schmelczer/ad_astra/promo_source/hf/IMG_20200516_105644.jpg

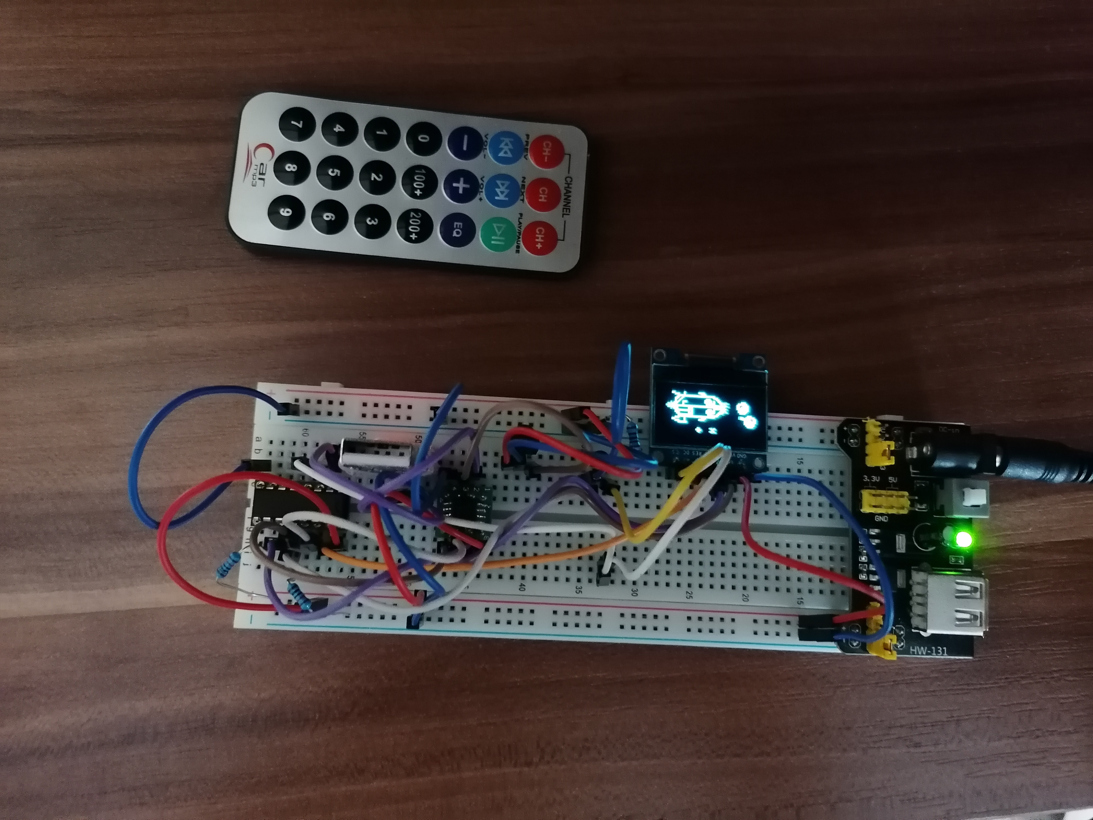
promo_source/hf/IMG_20200516_105644.jpg
