schmelczer/ad_astra/README.md

# Ad astra

## Demonstration

[View it on YouTube](https://youtu.be/BRTg24UXhKg)

## Directories
- [sprite_generator](sprite_generator/)
    > Contains a python script for transforming [Piskel](https://www.piskelapp.com/) sprites 
    > into C files.
- [ad_astra](ad_astra/)
    > Contains the source files for the game
