schmelczer/ad_astra/docs/documentation.pdf

Név: Schmelczer András | Neptun kód: CVTNXD

Beadás dátuma: 2020. 05. 19.

Házi feladat címe: Szimulációs játék

## Mikrokontrollerek alkalmazástechnikája házi feladat

### ATtiny85-ös mikrokontrollerrel szeretnék megvalósítani egy infrás távirányítóval irányítható játékot. A játék futásához nem kell emberi beavatkozás, magától is történnek benne események, viszont, ha fogunk egy távirányítót, akkor az egyik

karaktert (a három közül) irányíthatjuk vele. A videójáték űrhajós tematikájú, amiben fejlődni az aszteroidák szétlövésével lehetséges.

### A feladatot önállóan, meg nem engedett segítség nélkül oldottam meg:

### aláírás

Szimulációs játék | Schmelczer András

# Részletes specifikáció

A játék futásához nem kell emberi beavatkozás, magától is történnek benne események, viszont, amennyiben fogunk egy távirányítót, akkor az egyik karaktert irányíthatjuk vele. A rendszer 3.3 V-ról működtethető, fogyasztása nem haladja meg a 15 mW-ot.

Infrán keresztüli NEC protokollal történő kommunikációval hét különböző kérést küldhetünk. A kijelző fényereje állítható növekvő és csökkenő irányban, a képernyőn látható egyik karakter mozgatható négy irányban, illetve a képernyőn látható karakter késztethető cselekvésre.

A rendszerrel továbbá UART-on keresztül is lehet kommunikálni. Küldeni a távirányító által küldhető parancsok karakteres megfelelőjét lehet. Ezek az előző sorrenddel megegyezően a következők: ’+’, ’-’, ’w’, ’a’, ’s’, ’d’, ’ ’. Visszafele pedig egy képkocka kirajzolásának ideje érkezik pár másodperces időközönként.

Maga a játék az űrben játszódik. Ezen belül egy űrhajóban található a játékos által irányított karakter és pár másik, a gép által irányított karakter is. A karakterek az űrhajót irányíthatják (ehhez az irányítópulthoz kell menni, és megnyomni az akciógombot). Az űrhajóval lőni is lehet, ehhez egy másik irányítópulthoz kell menni. Az űrhajó egy részének a képernyőn mindig látszania kell, így azt nem lehet bármilyen távolra elirányítani.

Vizuálisan oldalnézetű képeket látunk. Az űrhajó kétszintes, ezek között, illetve ezeken belül tudnak a karakterek közlekedni. A két szintet egy létra köti össze, amelyen fel és lefele is lehet közlekedni. A lefele mozgásnak a létrán kívül nincs következménye. A felfele mozgást a létrán kívül végrehajtva egy ugró animációt láthatunk.

Ütközésnek számít az és csak az, amikor az űrhajó legalább egy sötét pixele fedésben van az aszteroida egy sötét pixelével. Az űrhajó ütközhet az aszteroidákkal, ilyenkor az energiája csökken. Az energia lövés hatására is csökken. Erről visszajelzést egy az űrhajó spritejába integrált csík szolgáltat. Ha a csík hosszúsága nulla, a játéknak vége, és egy effekt lejátszása után elölről kezdődik. Ezt elkerülendő a fedélzet megfelelő pontján kell az akciógombot megnyomni, ilyenkor újra feltöltődik a csík. Néha megjelennek aszteroidák, melyek szétlőhetők.

A spriteok animálhatók és az átlátszóság is biztosított. A háttérben csillagok mozognak véletlenszerű konfigurációkban. Utóbbiaknak nincs hatása a játékmenetre. Követelmény továbbá, hogy legalább 50 képkockát kirajzoljon másodpercenként legalább 64 x 32 pixeles felbontásban.

A játéknak figyelembe kell vennie az eddig felrobbantott aszteroidák számát, és ennek függvényében újabb funkciókat kell a játékos számára biztosítani. Ezek a funkciók sorrendben a következők: energia növelés lehetősége, lövés lehetősége, első segítő végül pedig a második segítő.

A segítők másik karaktereket jelölnek, akik egy többszintes szabályrendszert követve próbálják a játék előrehaladását segíteni. Minden funkció elérhető számukra, ami a játékos rendelkezésére is áll.

# Funkcionális blokkvázlat

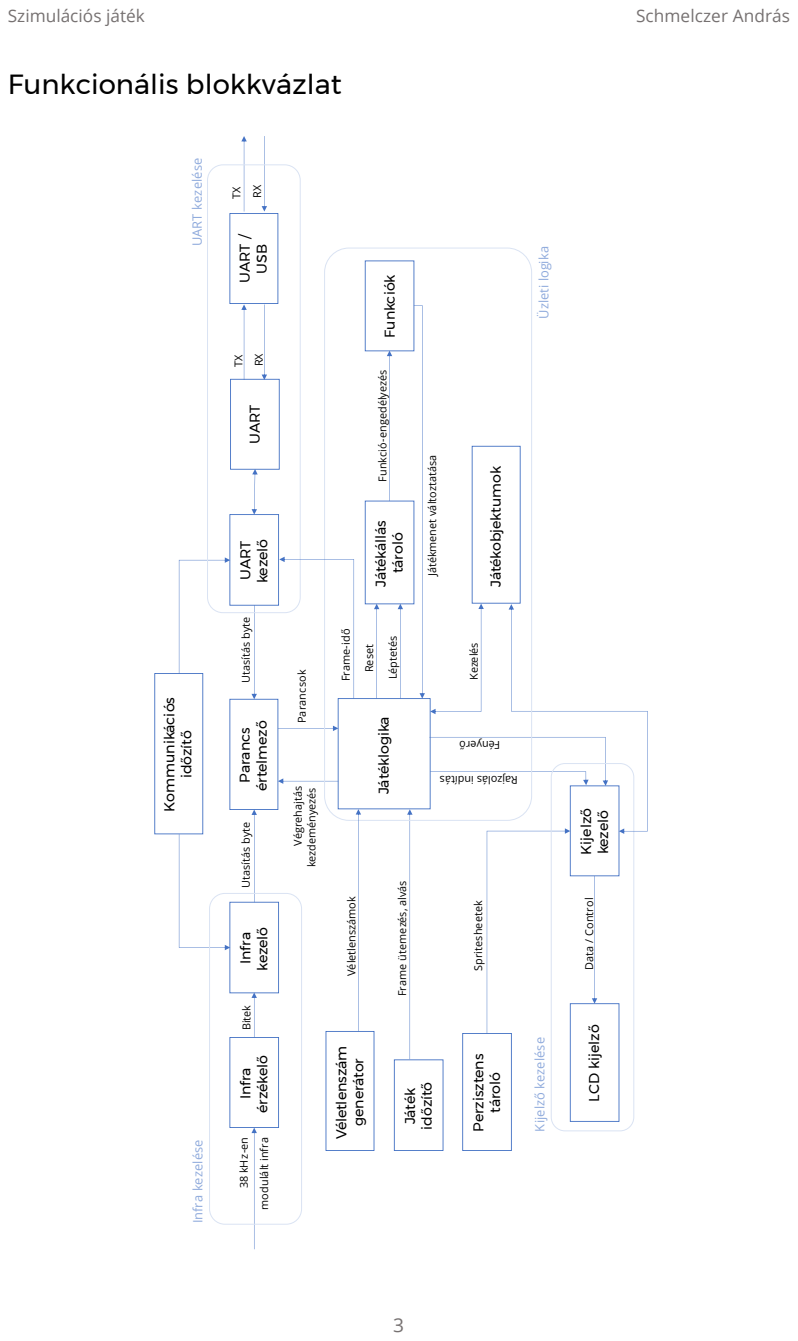
[picture p3: page 3]
Végrehajtás; kezdeményezés; arancsok; Véletlenszámok; pritesheetek; ata Control; itek k z -en; modulált infra; ijelző kezelése; eset; ezelés; zleti logika; átékmenet változtatása; rame-idő

nfra kezelése A kezelése

éptetés unkció-engedélyezés

tasítás byte

rame ütemezés, alvás

## Részletesebben

A specifikáció alapján az előző oldalon található blokkvázlatot készítettem. Sokat gondolkoztam a megfelelő absztrakciós szinten. Végül amellett döntöttem, hogy a játéklogika fáradtságos részletezése helyett annak csak a specifikációban kiemelt fő részeit tüntetem fel. Az eszköz viselkedésére már ennyiből is kellően nagy pontossággal lehet következtetni, a pontos implementáció és felbontás pedig rendkívül sokféle lehet. Szerencsére a többi követelmény elég egyértelműen vetíthető funkcionális blokkokra.

Mivel parancsokat több forrásból is kaphat a rendszer így a komplexitás csökkentése végett, azokhoz közös feldolgozóegységet célszerű használni. A kommunikációs protokollok bonyolultsága miatt ezekhez kezelőket is célszerű alkalmazni, így a rendszer többi része könnyebben veheti igénybe őket. Ezeknek a kezelőknek időzítőre is szükségük lesz.

Többször említésre került a követelmények közt a véletlenszerűségre igénye, ezek megvalósításához szükséges egy véletlenszám-generátor is. Továbbá explicit nem szerepelt a perzisztens tároló szükségessége, viszont az animált sprite-ok tárolását ezzel megoldhatjuk.

Az üzleti logika felel a követelményrendszer nagyobb részének teljesítéséért. Ennek kiemelendő funkciói a játékállapotának és a játék objektumoknak a felügyelete. Emellett a többi komponens működésének összeegyeztetése is ezen egység feladata.

# Hardver szoftver szétválasztás

Ezek után a hardver szoftver szétválasztás többnyire egyértelmű lesz. A ki és bemenetek (infra, UART, LCD) természetesen hardveresen kerülnek megvalósításra. Az időzítők és tárhely pedig a mikrokontrollerek felépítéséből következően szintén hardveresen manifesztálódnak. Jó hír, hogy ezeken kívül minden funkció megvalósítható szoftveresen is. A felbontást vizuálisan a következő oldalon láthatjuk.

## Diagram

A hardver által megvalósított részeket kék háttérszínű téglalapokkal jelöltem.

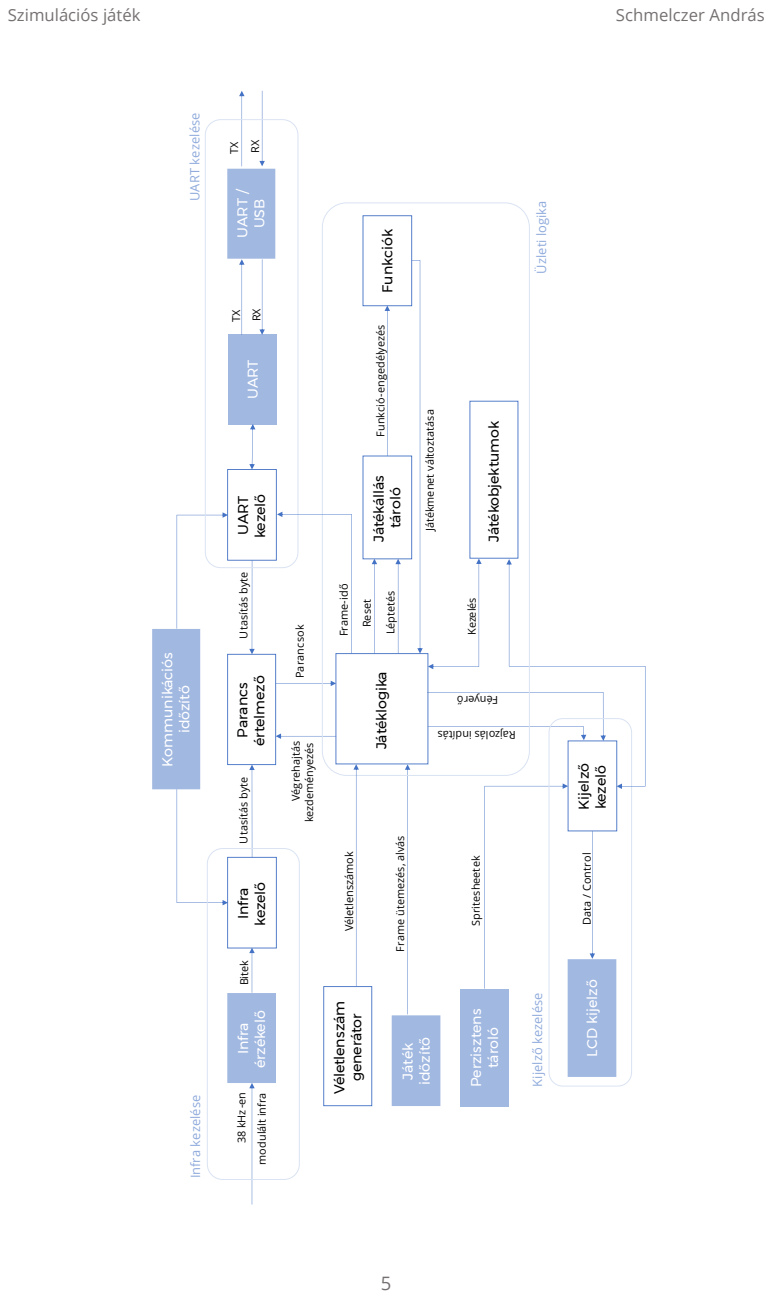
[picture p4: page 5]
Végrehajtás; kezdeményezés; arancsok; Véletlenszámok; pritesheetek; ata Control; itek k z -en; modulált infra; ijelző kezelése; eset; ezelés; zleti logika; átékmenet változtatása; rame-idő

nfra kezelése A kezelése

éptetés unkció-engedélyezés

tasítás byte

rame ütemezés, alvás

## Hardver blokkvázlat

Maga a mikrokontroller a korábban említett ATtiny85-ös lesz. Ez egy kellően olcsó és kis-
méretű eszköz, meglepően magas teljesítménnyel. | átránya a kisméretű | AM és
programmemória. Ezeket ügyes programozással kell áthidalni.

Egy 128 x 64 pixel felbontású SPI-on kommunikáló kijelző szolgál kimenetként, egy TSOP szériás infra érzékelő pedig bemenetként. A kijelző felbontása (és beépített hardveres gyorsítása) lehetővé teszi a kétszeres upscaling használatát, így elég 64 x 2 pixelnyi képet kiszámolni. Fejlesztés alatt a mikrokontroller debugWIRE interface-én kerül sor a debugolásra. A tárgykövetelmények miatt UART-os kommunikációra is szükség lesz, viszont a lábak elfogytak, így a kimeneti lábakat egy shift-regiszterrel kell bővíteni, amivel kvázi -on keresztül lehet kommunikálni.

A (kimeneti) portbővítés az eddigi funkcionális leírásokban nem szerepelt, hiszen ez nem a specifikációban részletezett funkcionalitáshoz szükséges, hanem egyszerűen a mikrokontroller kis lábszáma által okozott akadályt szünteti meg.

A két SPI lábakat használó periféria miatt szükséges a chip-select jelek használata, ezt egy inverter alkalmazásával biztosítom.

A mikrokontroller beépített USI-ja az | kezelésre lesz konfigurálva, lévén ez az időkriti-
kusabb a relatíve nagy sávszélességet igénylő képkockák átküldése miatt. Az A | és az
infra kezelésére pedig maradnak a pin change és timer interruptok.

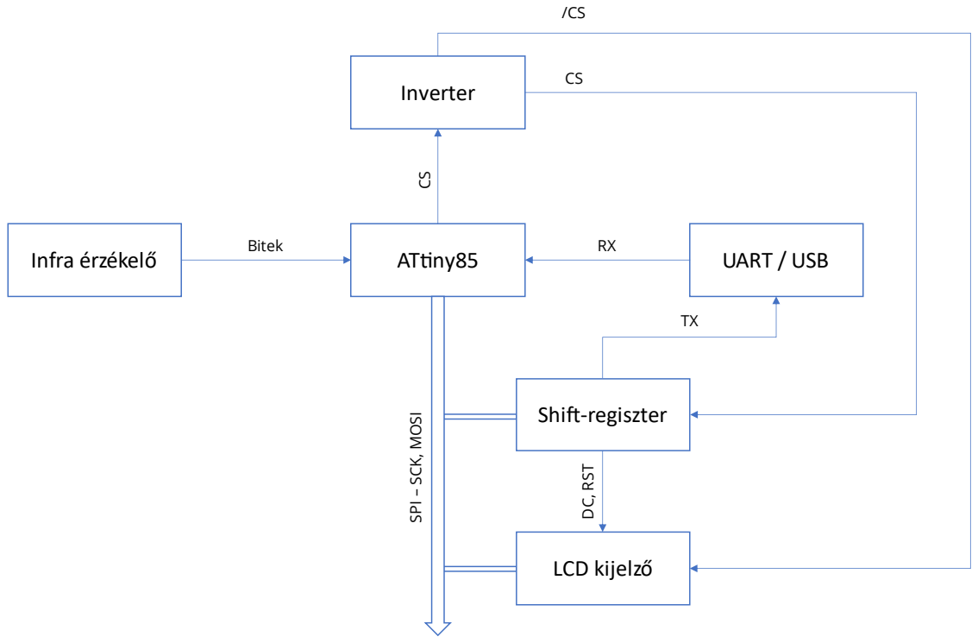
[picture p5: figure]
itek

# Kapcsolási rajz

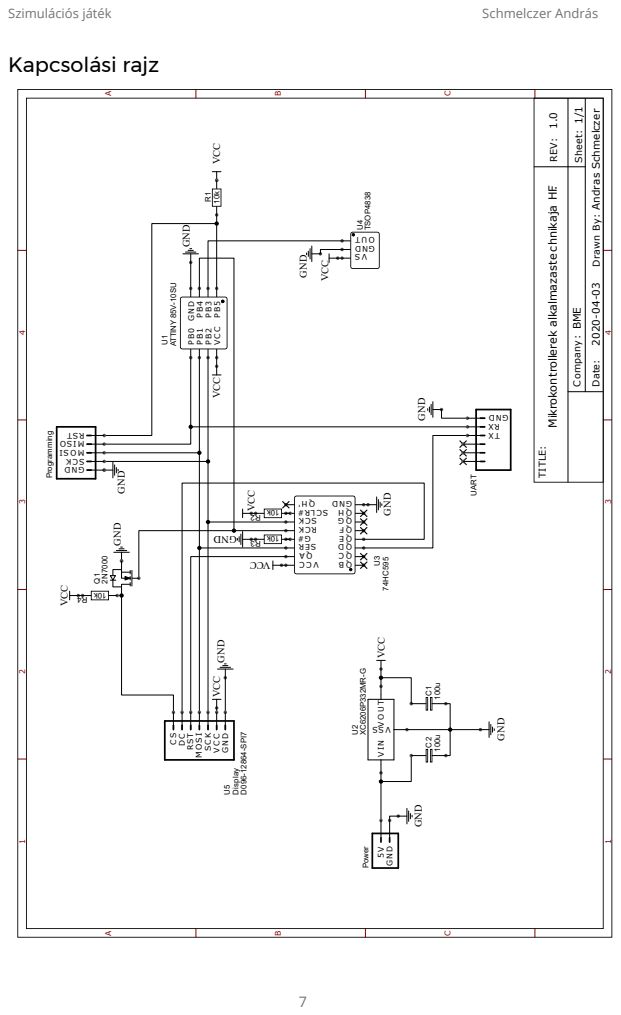
[picture p6: page 7]

# Szoftver rendszerterv

A teljes szoftveres dokumentációt mérete miatt nem illesztettem be ebbe a dokumentációba. A kommentek és a kód felépítése alapján doxygen-nel és pdlatex-kel generált dokumentáció a software_documentation.pdf fájlban található meg nyomtatható verzióban. öngésző segítségével célszerűbb a kereshető software_documentation/index.html fájlon keresztül elérhető dokumentációt használni.

Ebben a részben csak átfogóbb képet szeretnék adni a rendszerről. A részleteket az előbb említett helyen lehet megtalálni.

## Elvek

A szoftver architektúrájának tervezésekor fő szempontok voltak a modularitás, hordozhatóság és a teljesítmény. Nem elhanyagolható igény továbbá a kis méret sem. Mindezek teljesítése végett több alkalommal ismerhető fel az objektum-orientált szemlélet.

Ezek miatt a programban nincs globálisan elérhető állapot, a komponensek saját állapotukat felügyelik, velük függvényhívásokkal lehet kommunikálni.

## Hardverközeli

Madártávlatból három fő részre osztható a kódbázis. egalul helyezkedik el a hardware-access, ami a legalapvetőbb hardveres funkciókat látja el egy kényelmesen használható API-val. A következő hardver funkciókért felelős modulok találhatók itt.

- Energiahatékonyság
- SPI (sebesség végett blokkoló működés)
- dőzítés (megszakítás alapú működés)
- Digitális kimenet

Másik mikrokontrollerre váltás esetén a változtatások túlnyomó része az előbbi elemekben várható.

Ez a réteg rendelkezik egy açade jellegű interfésszel, aminek két felelőssége van. Egyrészt deklarálja a hardware-access által biztosított funkciókat. Másrészt a teljes hardveres inicializálásért felel. tóbbira a kis méret és az egyszerű használat miatt van szükség. A program elején inicializáljuk a HAL-t, utána pedig bárhol includeolva a megfelelő headert, a teljes hardver funkcionalitást elérjük.

## Driverek

A következő réteg a driver réteg. Az itteni modulok lazán csatoltak és egyetlen közös tulajdonságuk, hogy a HAL-t használják funkcionalitásuk megvalósításához.

A következő komponensek helyezkednek el itt.

- ijelző
- Infra (megszakítás alapú működés)
- Alvásütemezés
- UART (megszakítás alapú működés)

Ezek többnyire egy egyszerű interfész (callback függvény) átadásával inicializálhatók. Erre a laza csatoltság miatt van szükség, igazából ez a dependency inversion principle C nyelvi megvalósítása.

A legmagasabb szintű funkciók az alkalmazás réteg-ben találhatók. Maga a játék és annak logikája itt kerül megvalósításra. Ez saját belső architektúrával rendelkezik, amit a későbbiekben fogok kifejteni.

Végül egy fontos komponens maradt még. A mediator az alkalmazás és a driverek között helyezkedik el. iztosítja, hogy az előbbi két rétegen belül és azok közt megvalósulhasson a kommunikáció. elelőssége a komponensek orkesztrációja. Mindezt a megfelelő fejlécű függvények átadásával éri el a megfelelő inicializáló függvényhívásokban.

## Alkalmazáslogika

A fő szempont a magasszintű kód írásának lehetővé tétele és a kompakt méret. Ezért a játékobjektumok közt egy prototípus alapú öröklési rendszer került kialakításra. Minden típus rendelkezik egy prototípussal, ami a méretét, a rajzoló és a frissítő függvényét tartalmazza. Maguk a prototípusok a programmemóriában kerülnek tárolásra. Az objektumok rendelkeznek egy mutatóval a prototípusukra, egy pozícióval és egy unionnel, amiben a típus specifikus állapotukat tárolják.

Az objektumok tárolására az objektumtároló szolgál. Ez igazából egy heterogén kollekció pár hasznos függvénnyel. Például segítségével lekérdezhetők az objektumok típus alapján vagy az alapján, hogy adott pixel pozíciót tartalmazzák-e. Továbbá az objektumok frissítését és rajzolását lehet innen kezdeményezni.

Az időközönkénti új objektumok létrehozását az esemény generátor kezdeményezi. Emellett a játékmenetért (indítás, újraindításért) felelős komponens is ebben a rétegben kerül megvalósításra.

Az összes játékobjektum típus rendelkezik saját komponenssel. Adott feladatukat a program többi részét használva igen magas szintű kóddal lehet megvalósítani. Önálló komponense van továbbá az AI-nak, ami az élő felhasználó által használható interfészen keresztül irányíthatja a karaktereket.

Megemlíthető, hogy a kirajzolásra szánt spritesheetek is itt kerülnek definiálásra a kijelző által elvárt speciális formátumban. Ezek az EEPROM-ban kerülnek tárolásra.

## Segédfüggvények

Egyéb sztenderd könyvtár jellegű segédfunkciók is helyet kapnak a kódbázisban. Ezek működése elég magától értetődő. elsorolás jelleggel a következő komponensekről van szó.

- Véletlenszámgenerátor
- Vektor (2 dimenziós)
- Téglalap
- Makrók
- Null
- it műveletek

# Felhasználói leírás és kezelési útmutató

Az eszköz bekapcsolásához szükséges egy 3.3 V-os tápfeszültséget biztosítani számára. Ezután az UART – USB átalakító csatlakoztatva a számítógéphez, egy terminál alkalmazással (például PuTTY) csatlakozhatunk az eszközhöz.

lyenkor az E kijelzőn egy karaktert láttunk az űrhajóban állni. Ezt a karaktert kétféleképpen irányíthatjuk. Egyrészt használhatjuk az imént elindított soros kommunikációt, vagy az eszközhöz tartozó infrás távirányítót is. Előbbi esetén a ’w’, ’a’, ’s’, ’d’ és szóköz billentyűk lenyomásával mozgathatjuk a karaktert, illetve vehetjük rá, hogy interakcióba lépjen a környezetével. A ’+’ és ’-’ billentyűk lenyomásával a kijelző fényerejét változtathatjuk. ávirányító esetében ezeknek a ’2’, ’4’, ’ ’, ’6’, ’5’, ’+’ és ’-’ billentyűk felelnek meg. izonyos időközönként a soros porton egy ’szám ms’ alakú üzenet érkezik, ami megadja, hogy az előző ilyen üzenet óta mennyi időbe telt a leglassabban előállított kép kirajzolása.

A játék célja, az aszteroidák felrobbantása, miközben az űrhajó épséget megőrizzük. Aszteroidák felrobbanthatóak, ha az űrhajóval ütköznek, vagy lelövik őket. Az űrhajó mozgatásához annak jobb felső részéhez érve kell interakció gombot nyomni. Ettől kezdve a karakter helyett az űrhajót mozgatják a gombnyomások. Visszaváltani az interakció gomb ismételt lenyomásával lehetséges.

ellő mennyiségű felrobbantott aszteroida után az űrhajó felszereltsége nő. Az újonnan megjelenő tárgyakkal is interakcióba lehet lépni. al alul az űrhajót javíthatjuk (a jelenlegi állapotát jobb középen elhelyezett csíkon láthatjuk). Jobb alul található az ágyú. A felszereltség növekedése mellett gép által irányított űrhajósók is megjelenhetnek, akik elvárható pontosággal végzik a szükséges feladatokat a játék célja eléréséért.

Ha a korábban említett csík hossza nullára csökken, egy animáció lejátszása után a játék elölről kezdődik.

# Bemérési tapasztalatok

Többször volt szükséges átépíteni a hardvert amiatt, mert az olcsó és kisméretű breadboard-ok csatlakozói nagyon hamar elhasználódnak. Emiatt legközelebb mindenképpen egy komolyabb breadboard-on kezdeném el a prototipízálást.

Emellett a fejlesztés első fázisában fejlesztőkártyát (vagy külső debuger-t) használnék a beépített debugolási lehetőségek miatt. ovábbá célszerű, ha mindenből legalább egy tartalék van nálunk, erre nemegyszer volt szükségem.

Alkatrészek kapcsán legpozitívabban a TSOP-ban csalódtam, nagyon jólszűrt és erős jelet ad még akkor is, ha az infra forrása relatíve messze van tőle.

# Elkészült eszköz

Egy kép a dokumentációban részletezett eszköz breadboardon elkészült prototípusáról.

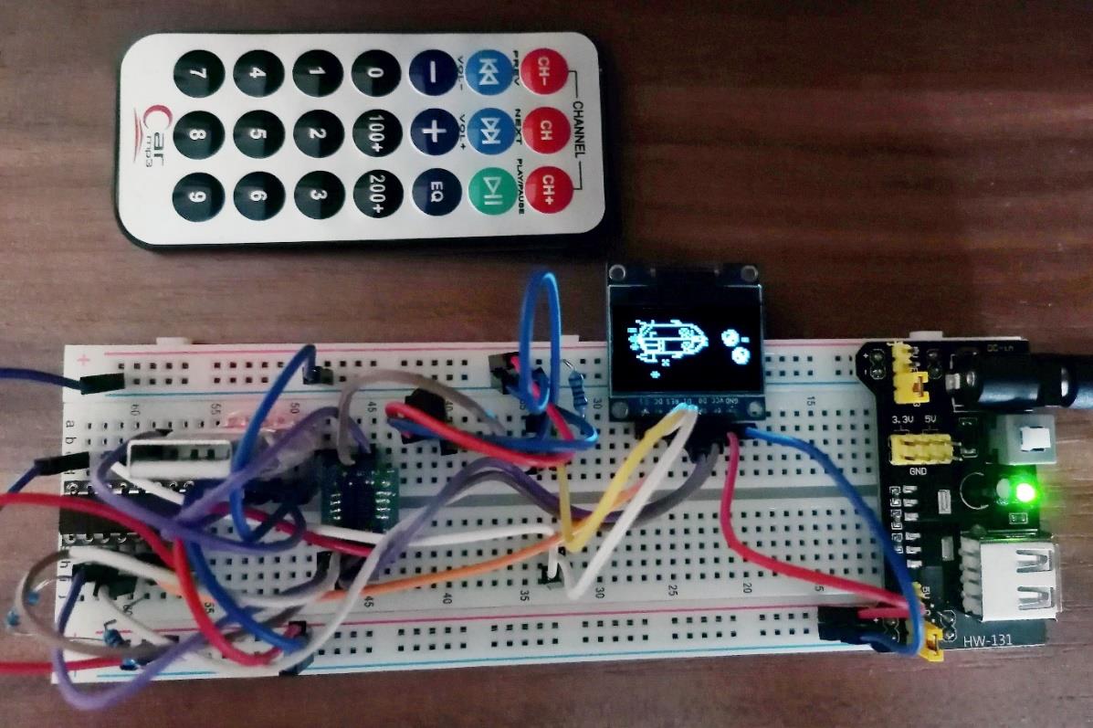
[picture p7: figure]

Az előző eszköz alapján készített, továbbfejlesztett konfiguráció pedig ezen a képen látható. Utóbbiról több információ a https://schmelczer.dev oldalon található.

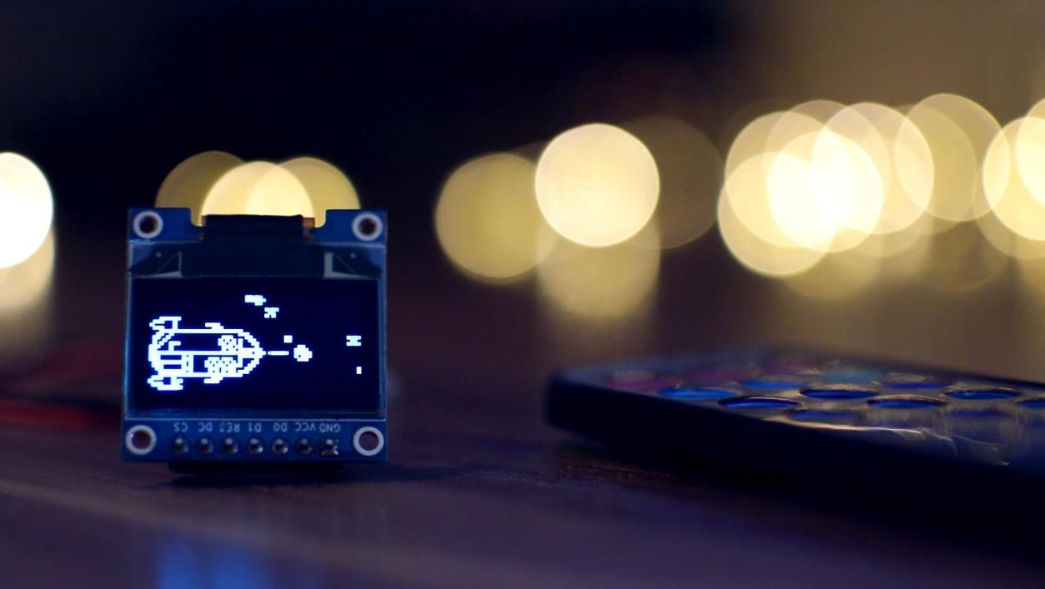
[picture p8: figure]

# Datasheet borítók

A következőkben a felhasznált hardverek datasheetjeinek első oldalát másoltam be. Ezek a következő chipekhez tartozó boritók:

- 2N7000G
- 74HC595
- D096128-SPI-7
- ATTINY85-V
- TSOP48

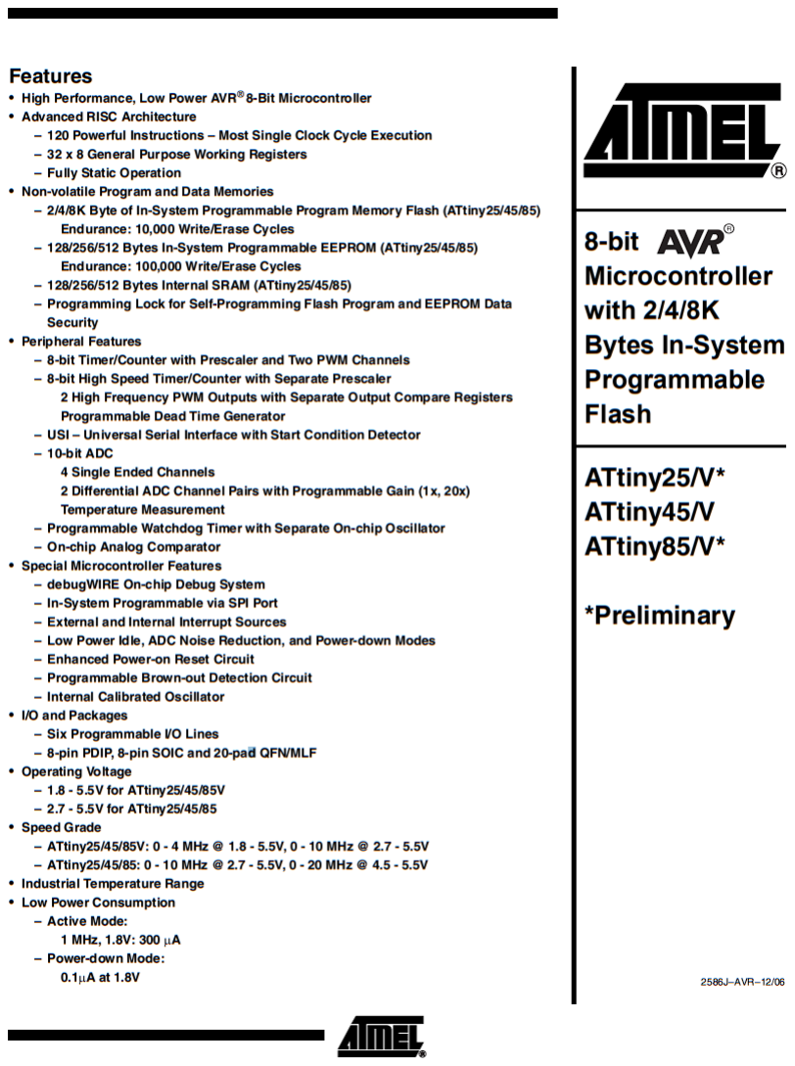
[picture p9: figure]

2N7000G

## Small Signal MOSFET 200 mAmps, 60 Volts

### N−Channel TO−92

Features
AEC Qualified
PPAP Capable
This is a Pb−Free Device*

MAXIMUM RATINGS

Rating | Symbol | Value | Unit
Drain Source Voltage | V DSS | 60 | Vdc
− t t ( GS = 1.0 MW) | V DGR | 60 | Vdc
t − c t − Continuous − − t t v (tp ≤ ) | GS V GSM | ±Ê20 V ±Ê40 | Vdc Vpk
Drain Current − Continuous − Pulsed | ID I DM | 200 500 | mAdc
Total Power Dissipation @ TC = 25°C | P
D | 350 | mW
Derate above 25°C | 2.8 | mW/°C
Operating and Storage Temperature | T
J
, Tstg | −55 to +150 | °C
Range

THERMAL CHARACTERISTICS

Characteristic | Symbol | Max | Unit
h t c , J ct −t − b t | RqJA | 357 | °C/W
Maximum Lead Temperature for | TL | 300 | °C
d | , / ″ f | c
for 10 seconds

Stresses exceeding Maximum Ratings may damage the device. Maximum Ratings are stress ratings only. Functional operation above the Recommended Operating Conditions is not implied. Extended exposure to stresses above the Recommended Operating Conditions may affect device reliability.

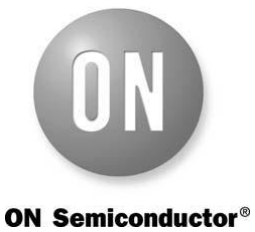
[picture p10: figure]

http://onsemi.com

200 mAMPS

### 60 VOLTS

R
DS(on)

= 5 W

N−Channel

D

G

S

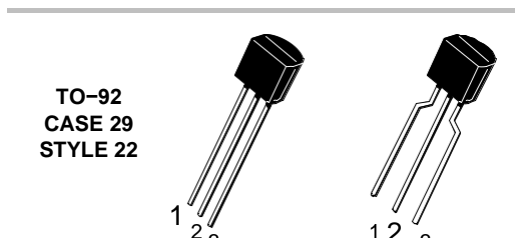
[picture p11: figure]
TO−92 CASE 29 STYLE 22

2
3

1 2 3

STRAIGHT LEAD | BENT LEAD
BULK PACK | TAPE & REEL
| AMMO PACK

MARKING DIAGRAM
AND PIN ASSIGNMENT

2N
7000
AYWW
G
G
1 | 3
Source | Drain
2
Gate
A | = Assembly Location
Y | = Year
WW | = Work Week
G | = b−F | c
(Note: Microdot may be in either location)

ORDERING INFORMATION

See detailed ordering and shipping information in the package dimensions section on page 2 of this data sheet.
*F | dd t | f | t | b−F | t t | d | d | d t | ,
please download the ON Semiconductor Soldering and Mounting
Techniques Reference Manual, SOLDERRM/D.
© Semiconductor Components Industries, LLC, 2011 | 1 | Publication Order Number:
April, 2011 − Rev. 8 | | 2N7000/D

### INTEGRATED CIRCUITS

# DATA SHEET

# 74HC595; 74HCT595 8-bit serial-in, serial or parallelout shift register with output latches; 3-state

Product specification | 2003 Jun 25

### Supersedes data of 1998 Jun 04

### SOLOMON SYSTECH

SEMICONDUCTOR TECHNICAL DATA

# SSD1306

### ADVANCE INFORMATION

## 128 x 64 Dot Matrix OLED/PLED Segment/Common Driver with Controller

This document contains information on a new product. Specifications and information herein are subject to change without notice.

http://www.solomon-systech.com
SSD1306 | Rev 1.2 | P 1/63Jul 2009 | Copyright © 2009 Solomon Systech Limited

TSOP22.., TSOP24.., TSOP48.., TSOP44..
www.vishay.com | Vishay Semiconductors

## IR Receiver Modules for Remote Control Systems

FEATURES

- | v d | t | t F | d F
- L | c | t
- h t detector and preamplifier in one package
- t | f t | f | f q | c
- | v t | : . | t | .

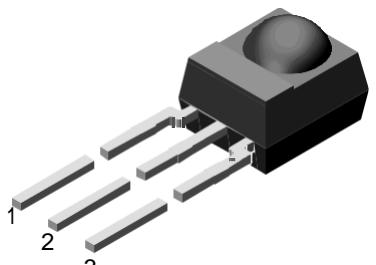
[picture p12: figure]

1 | • | v d | t | t | t c
- | t v t | v t | d 3 | 16672
- | t | c t | z t | :
MECHNICAL DATA | for definitions of compliance please see
www.vishay.com/doc?99912
Pinning for TSOP44.., TSOP48..:

1=OUT,2=GND,3=VS Pinning
for TSOP22.., TSOP24..:
1=OUT,2=VS,3=GND

DESCRIPTION

The TSOP22.., TSOP48.., TSOP24.. and TSOP44.. series are miniaturized IR receiver modules for infrared remote control systems. A PIN diode and a preamplifier are assembled on lead frame, the epoxy package contains an IR filter.

The demodulated output signal can be directly connected to a microprocessor for decoding.

The TSOP24.., TSOP44.. series devices are optimized to suppress almost all spurious pulses from Wi-Fi and CFL sources. They may suppress some data signals if continuously transmitted.

The | TSOP22.., | TSOP48.. | series | devices | are
provideddesigns should prefer the TSOP24.., TSOP44.. series containing the newer AGC4.

These components have not been qualified according to automotive specifications.

PARTS TABLE

AGC | LEGACY, FOR LONG BURST REMOTE CONTROLS (AGC2) | RECOMMENDED FOR LONG BURST CODES (AGC4)
| 30 kHz | TSOP4830 | TSOP2230 | TSOP4430 | TSOP2430
| 33 kHz | TSOP4833 | TSOP2233 | TSOP4433 | TSOP2433
Carrier | 36 kHz | TSOP4836 | TSOP2236 | TSOP4436 (1)(2)(3) | TSOP2436 (1)(2)(3)
frequency | 38 kHz | TSOP4838 | TSOP2238 | TSOP4438 (4)(5)(6) | TSOP2438 (4)(5)(6)
40 kHz | TSOP4840 | TSOP2240 | TSOP4440 | TSOP2440
56 kHz | TSOP4856 | TSOP2256 | TSOP4456 (6)(7) | TSOP2456 (6)(7)
Package | Mold
Pinning | 1=OUT,2=GND,3=VS | 1=OUT,2=VS,3=GND | 1=OUT,2=GND,3=VS | 1=OUT,2=VS,3=GND
Dimensions (mm) | 6.0 W x 6.95 H x 5.6 D
Mounting | Leaded
Application | Remote control
Best remote control code | (1) RC-5 (2) RC-6 (3) Panasonic (4) NEC (5) Sharp (6) r-step (7) Thomson RCA
Rev. 1.5, 10-Nov-15 | 1 | Document Number: 82459

THIS DOCUMENT IS SUBJECT TO CHANGE WITHOUT NOTICE. THE PRODUCTS DESCRIBED HEREIN AND THIS DOCUMENT ARE
| SUBJECT TO SPECIFIC DISCLAIMERS, SET FORTH AT www.vishay.com/doc?91000
