schmelczer/ad_astra/promo_source/hf/IMG_20200516_105551.jpg

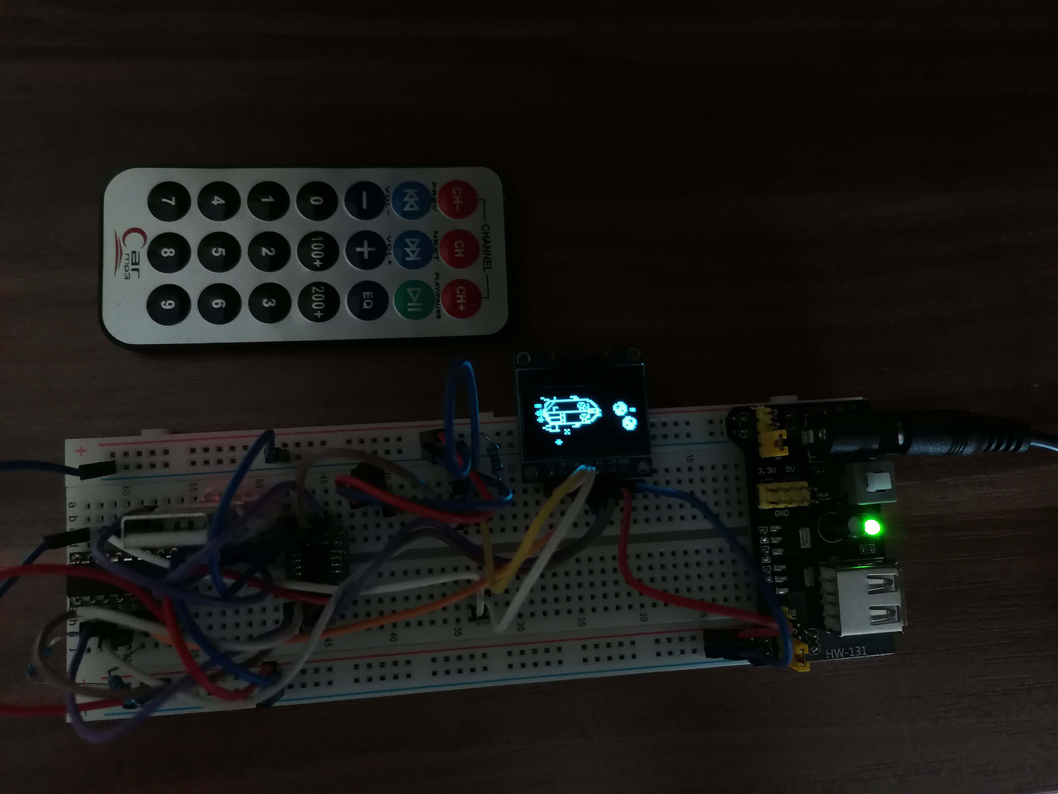
promo_source/hf/IMG_20200516_105551.jpg
