schmelczer/ad_astra/promo_source/hf/IMG_20200516_105558.jpg

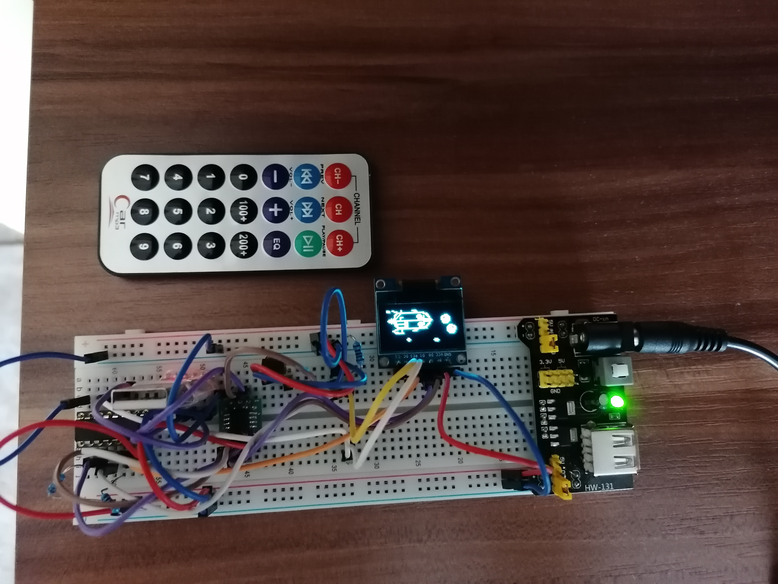
promo_source/hf/IMG_20200516_105558.jpg
