schmelczer/ad_astra/promo_source/hf/IMG_20200516_105634.jpg

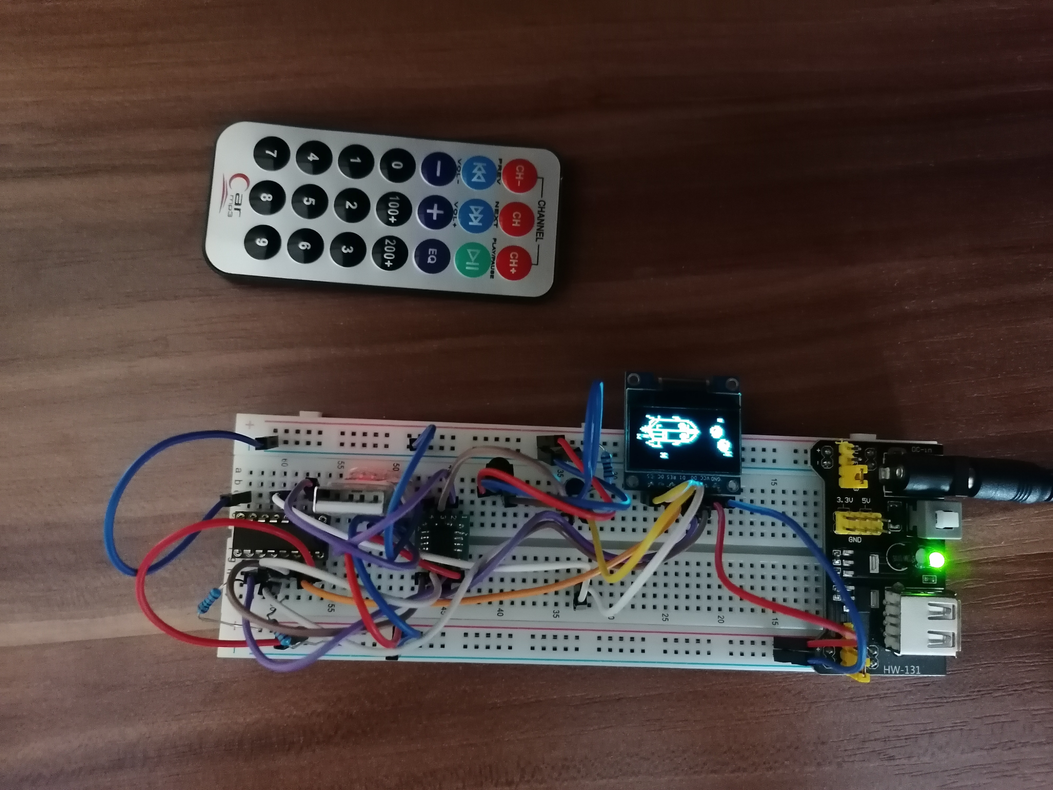
promo_source/hf/IMG_20200516_105634.jpg
