schmelczer/ad_astra/docs/BOM.csv

ID | Name | Designator | Footprint | Quantity
1 | M02 | JP3 | 1X02 | 1
2 | 10k | R1,R2,R3,R4 | 0603' | 4
3 | 74HC595 | U3 | DIP-16_L19.8-W6.5-P2.54-LS7.6-BL | 1
4 | TSOP4838 | U4 | SENSOR-TH_TSOP4X | 1
5 | 2N7000 | Q1 | TO-92-3_L4.9-W3.7-P1.27-L | 1
6 | ATTINY85V-10SU | U1 | SOIC-8_L5.3-W5.3-P1.27-LS8.0-BL | 1
7 | 100u | C1,C2 | 0603' | 2
8 | D096-12864-SPI7 | U5 | 1X07 | 1
9 | XC6206P332MR-G | U2 | SEEED-SOT-23 | 1
10 | M06 | JP4 | 1X06 | 1
11 | M05 | JP2 | 1X05 | 1
