schmelczer/ad_astra/docs/schematic.pdf

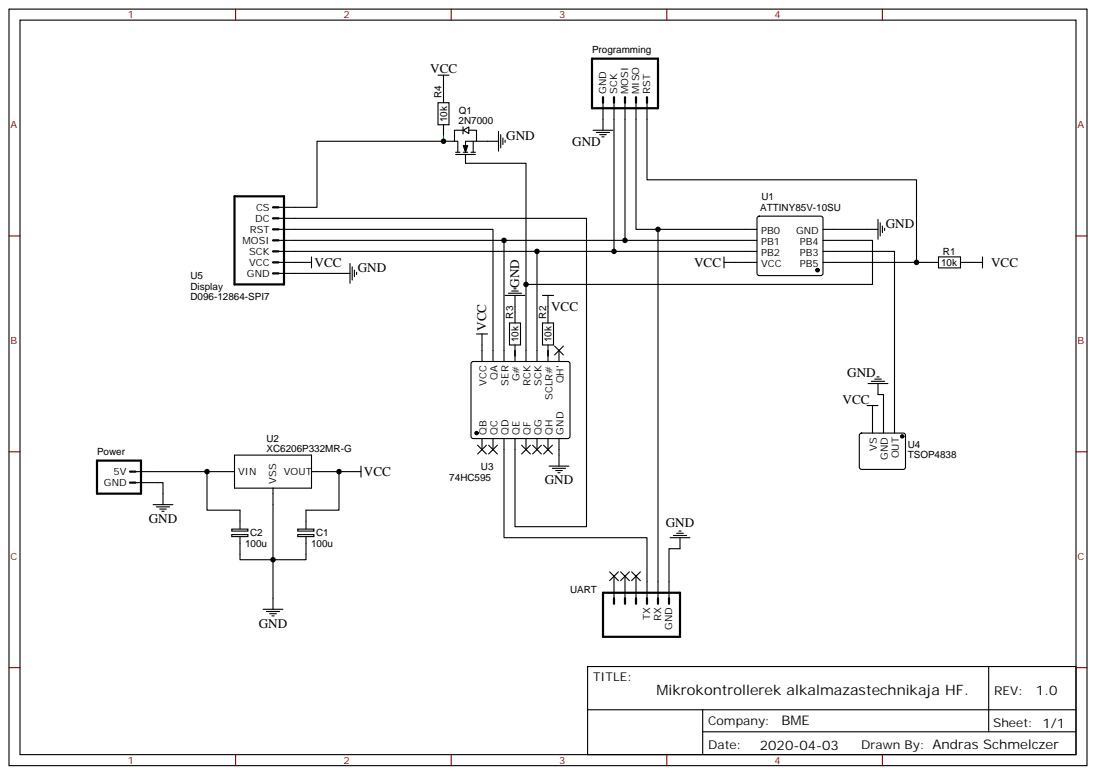
[picture p28: page 1]

Drawn By: Andras Schmelczer
