schmelczer/ad_astra/(commit log)

2020-04-19 Add PCB design
2020-04-20 Fix issue from copypaste
    [display.c]
2020-06-07 Add documentation
    [BOM.csv]
